Adi1011-Data/ESC-ESP32C3/ESC-ESP32.step

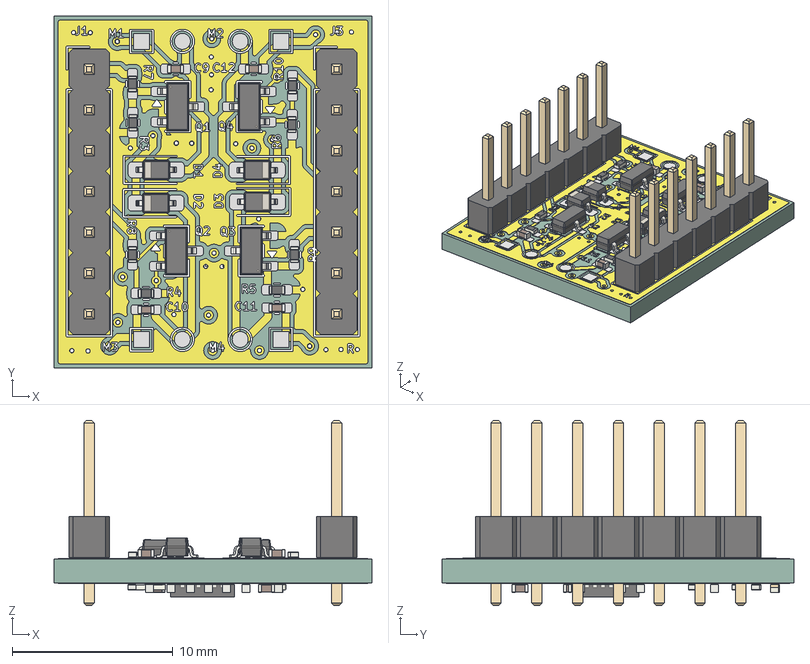
[picture p3: CAD file, 2026-10-14]
ESC-ESP32.step
19.8 x 21.9 x 11.5 mm
D_SOD-323 x 4
PinHeader_1x07_P2.54mm_Vertical x 2
R_0402_1005Metric x 14
SOT-23 x 4
C_0402_1005Metric x 14
LED_0402_1005Metric x 2
QFN-24-1EP_4x4mm_P0.5mm_EP2.7x2.7mm
ESC_copper
ESC_pad
ESC_via
ESC_silkscreen x 2
ESC_PCB
