Adi1011-Data/ESC-ESP32C3/ESC.kicad_pcb

## KiCad design ESC.kicad_pcb (2026-10-14)

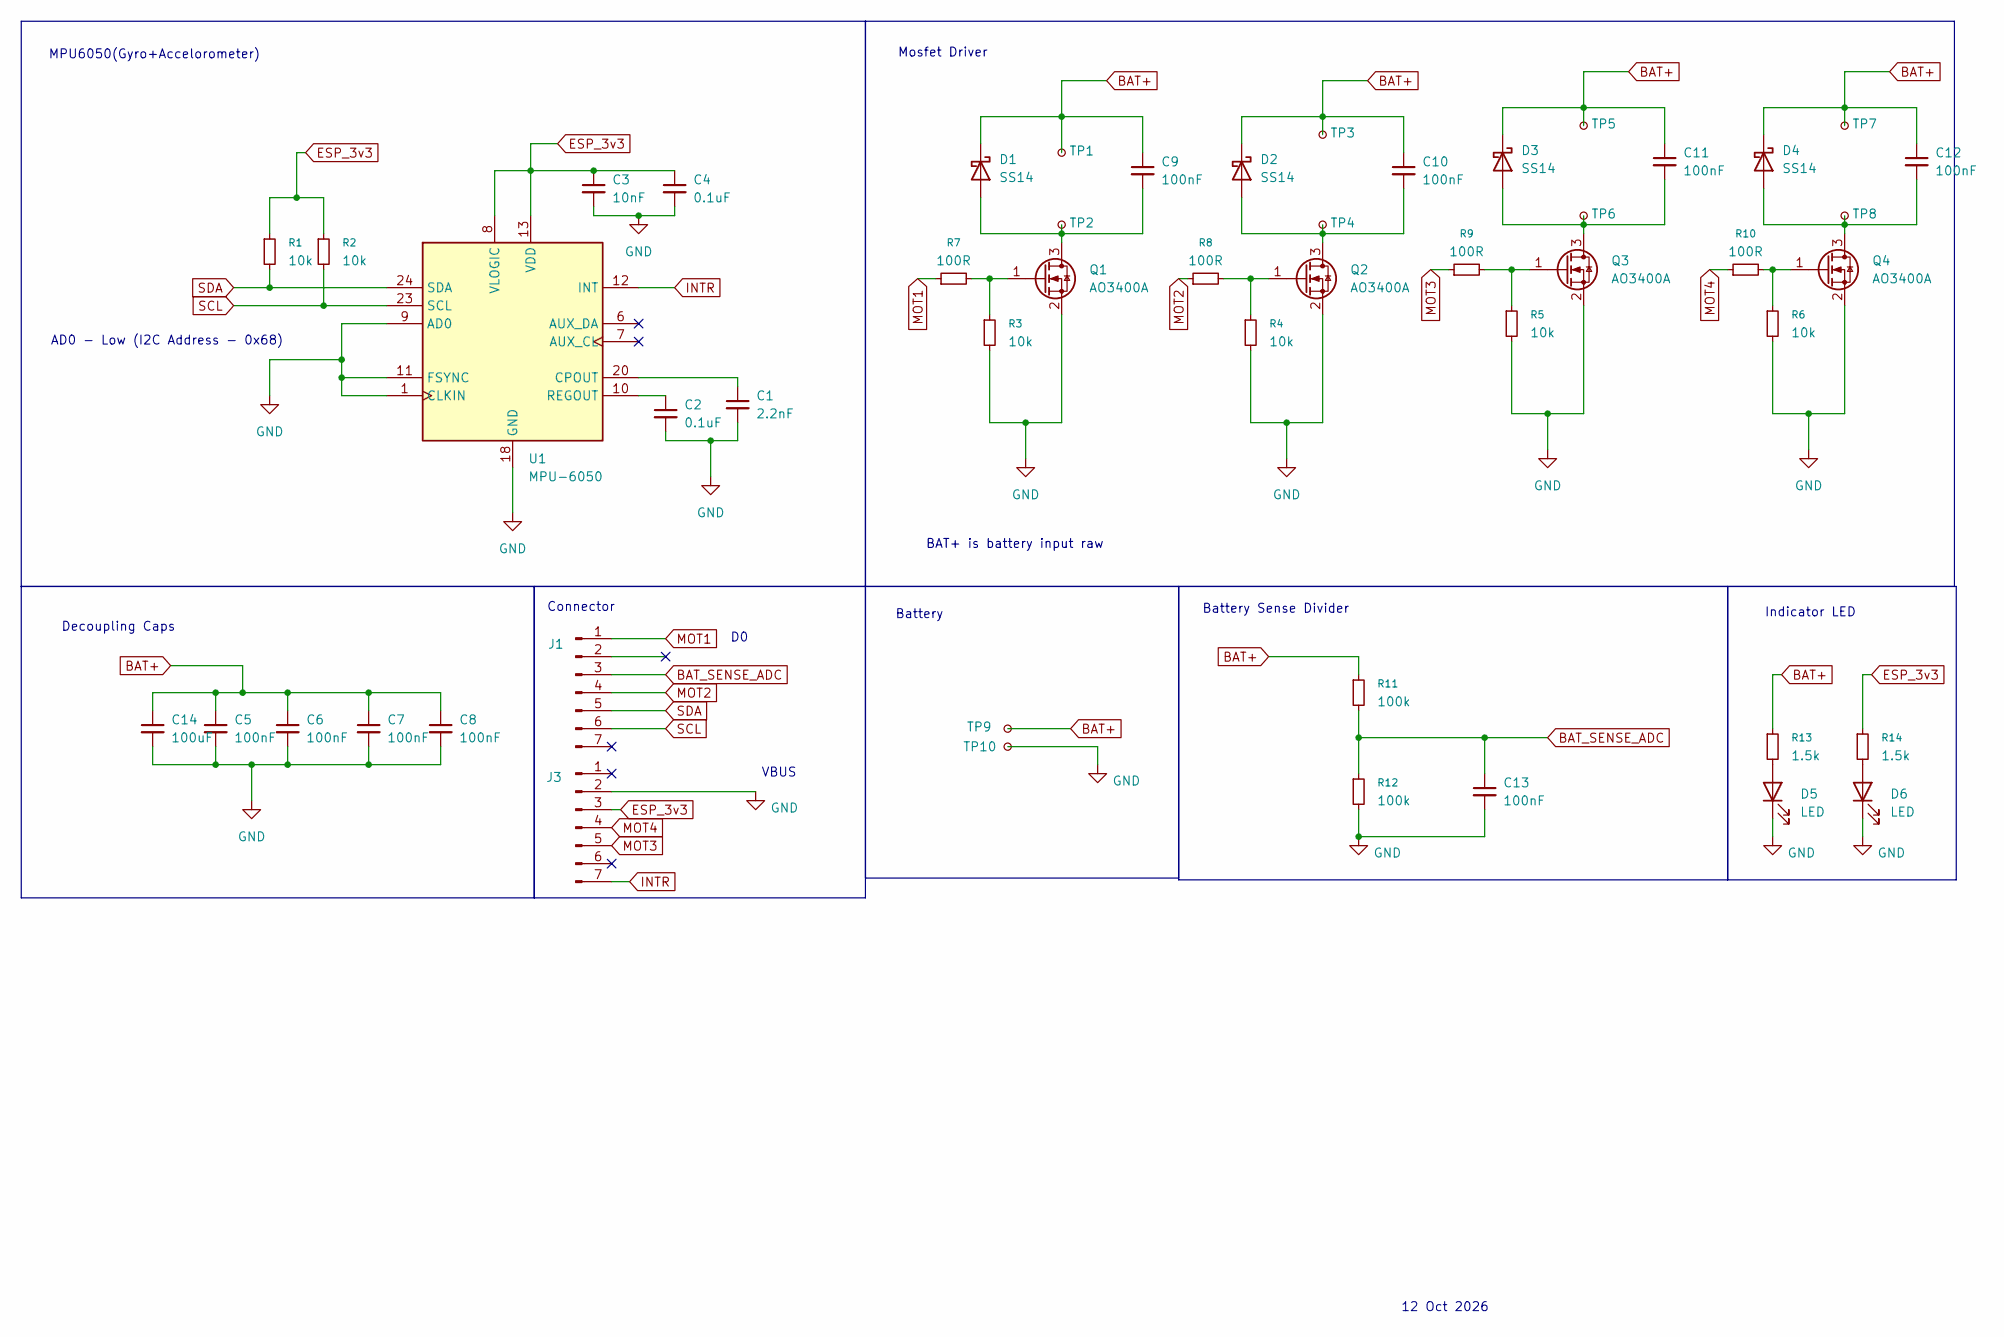
[picture p4: schematic ESC.kicad_sch]

Parts:
C1: 2.2nF; C_0402_1005Metric_Pad0.74x0.62mm_HandSolder
C2, C4: 0.1uF; C_0402_1005Metric_Pad0.74x0.62mm_HandSolder
C3: 10nF; C_0402_1005Metric_Pad0.74x0.62mm_HandSolder
C5, C6, C7, C8, C9, C10, C11, C12, C13: 100nF; C_0402_1005Metric_Pad0.74x0.62mm_HandSolder
C14: 100uF; C_0402_1005Metric_Pad0.74x0.62mm_HandSolder
D1, D2, D3, D4: SS14; D_SOD-323_HandSoldering
D5, D6: LED; LED_0402_1005Metric_Pad0.77x0.64mm_HandSolder
J1, J3: Conn_01x07_Pin; PinHeader_1x07_P2.54mm_Vertical
Q1, Q2, Q3, Q4: AO3400A; SOT-23
R1, R2, R3, R4, R5, R6: 10k; R_0402_1005Metric_Pad0.72x0.64mm_HandSolder
R7, R8, R9, R10: 100R; R_0402_1005Metric_Pad0.72x0.64mm_HandSolder
R11, R12: 100k; R_0402_1005Metric_Pad0.72x0.64mm_HandSolder
R13, R14: 1.5k; R_0402_1005Metric_Pad0.72x0.64mm_HandSolder
TP1, TP3, TP5, TP7, TP9: TestPoint_Small; TestPoint_Pad_1.0x1.0mm
TP2, TP4, TP6, TP8, TP10: TestPoint_Small; TestPoint_Pad_D1.0mm
U1: MPU-6050; InvenSense_QFN-24_4x4mm_P0.5mm

Connections:
BAT+: C5.1, C6.1, C7.1, C8.1, C9.1, C10.1, C11.1, C12.1, C14.1, D1.1 (K), D2.1 (K), D3.1 (K), D4.1 (K), R11.1, R13.1, TP1.1 (1_1), TP3.1 (1_1), TP5.1 (1_1), TP7.1 (1_1), TP9.1 (1_1)
BAT_SENSE_ADC: C13.1, J1.3, R11.2, R12.1
ESP_3v3: C3.1, C4.1, J3.3, R1.1, R2.1, R14.1, U1.8 (VLOGIC), U1.13 (VDD)
GND: C1.2, C2.2, C3.2, C4.2, C5.2, C6.2, C7.2, C8.2, C13.2, C14.2, D5.1 (K), D6.1 (K), J3.2, Q1.2 (S), Q2.2 (S), Q3.2 (S), Q4.2 (S), R3.2, R4.2, R5.2, R6.2, R12.2, TP10.1 (1_1), U1.1 (CLKIN), U1.9 (AD0), U1.11 (FSYNC), U1.18 (GND)
INTR: J3.7, U1.12 (INT)
MOT1: J1.1, R7.1
MOT2: J1.4, R8.1
MOT3: J3.5, R9.1
MOT4: J3.4, R10.1
unnamed: C9.2, D1.2 (A), Q1.3 (D), TP2.1 (1_1)
unnamed: C10.2, D2.2 (A), Q2.3 (D), TP4.1 (1_1)
unnamed: C11.2, D3.2 (A), Q3.3 (D), TP6.1 (1_1)
unnamed: C12.2, D4.2 (A), Q4.3 (D), TP8.1 (1_1)
unnamed: D5.2 (A), R13.2
unnamed: D6.2 (A), R14.2
unnamed: Q1.1 (G), R3.1, R7.2
unnamed: Q2.1 (G), R4.1, R8.2
unnamed: Q3.1 (G), R5.1, R9.2
unnamed: Q4.1 (G), R6.1, R10.2
unnamed: C1.1, U1.20 (CPOUT)
unnamed: C2.1, U1.10 (REGOUT)
SCL: J1.6, R2.2, U1.23 (SCL)
SDA: J1.5, R1.2, U1.24 (SDA)

Notes on the sheet:
BAT+ is battery input raw
Battery Sense Divider
12 Oct 2026
Decoupling Caps
Indicator LED
MPU6050(Gyro+Accelorometer)
Mosfet Driver
Battery
AD0 - Low (I2C Address - 0x68)
Connector
VBUS

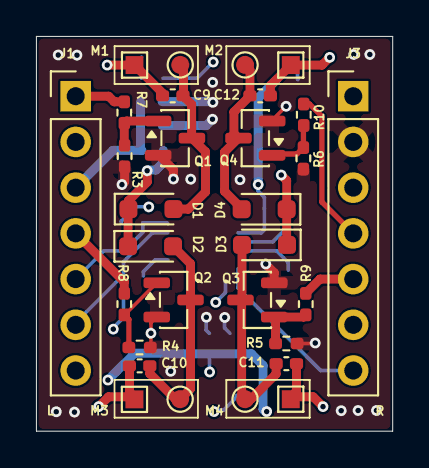
[picture p5: board ESC.kicad_pcb from above]

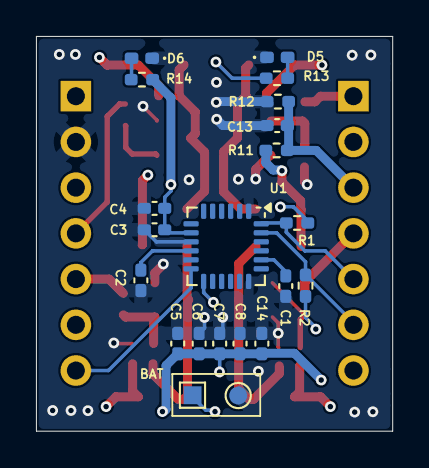
[picture p6: board ESC.kicad_pcb from below]

Board: 4 copper layers, 19.8 x 21.9 mm, 51 parts (21 on the bottom side), 23 nets.
