Adi1011-Data/ESC-ESP32C3/(commit log)

2026-10-14 Add the XIAO ESP32-C3 ESC board design.
    [ESC-BOM.csv, ESC-ESP32.step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]
2026-10-14 Place the ESC project at the repository root.
    [ESC-BOM.csv, ESC-ESP32.step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]
2026-10-14 Add a build guide and PCB images to the README.
2026-10-14 Update assembly instructions for XIAO ESP32-C3
    Clarified instructions for plugging in the XIAO ESP32-C3 by referencing 'R' and 'L' on the PCB.
